ajs28-lgtm/elec327_final_project/docs/final_pcb.webp

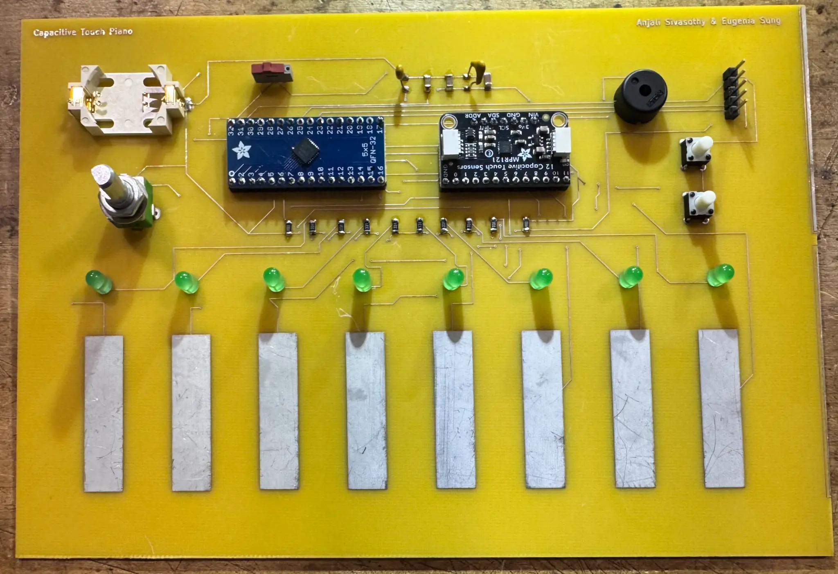
docs/final_pcb.webp
