ajs28-lgtm/elec327_final_project/docs/docs/ELEC327ProjectSlides.pdf

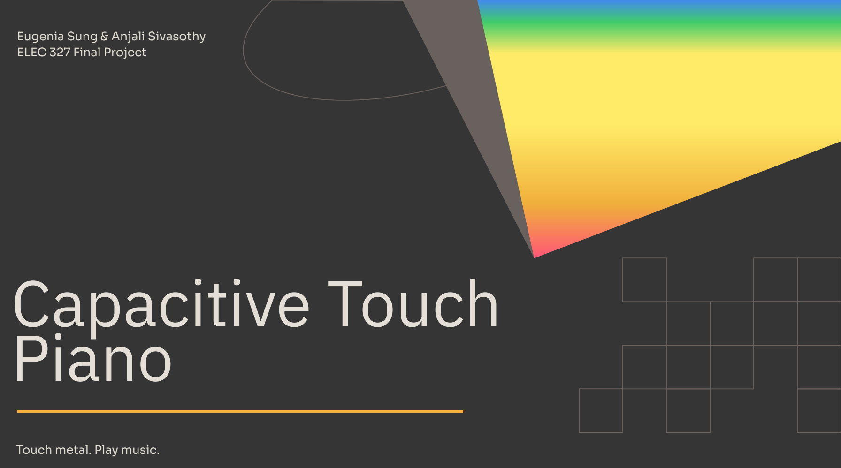
[picture p2: figure]
Eugenia Sung & Anjali Sivasothy ELEC 327 Final Project; Capacitive Touch Piano; Touch metal. Play music.
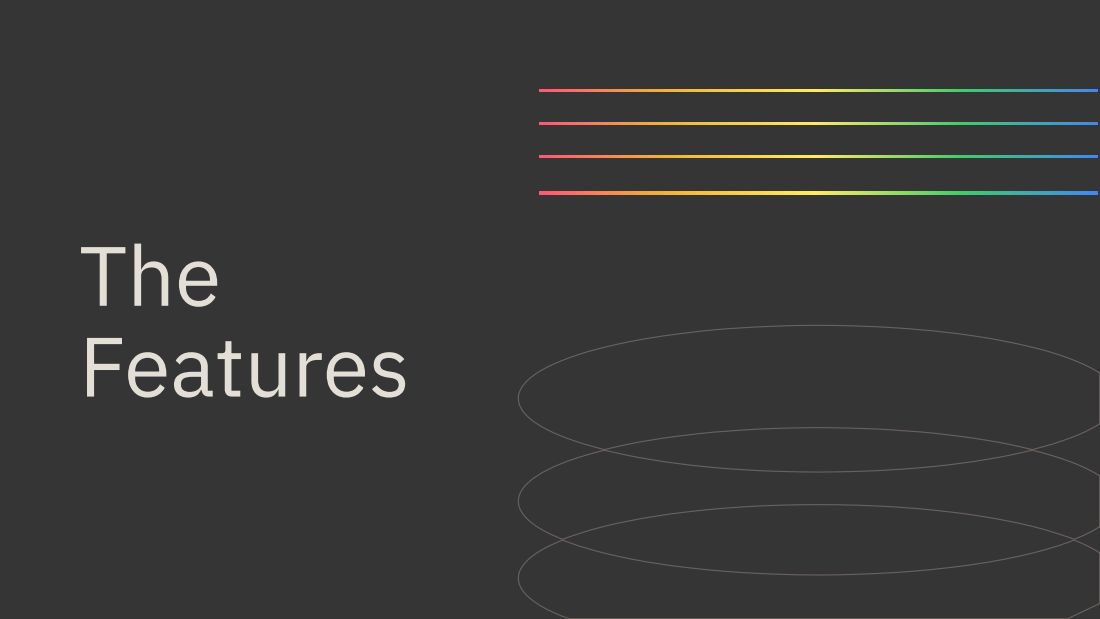
[picture p3: page 2]
The Features

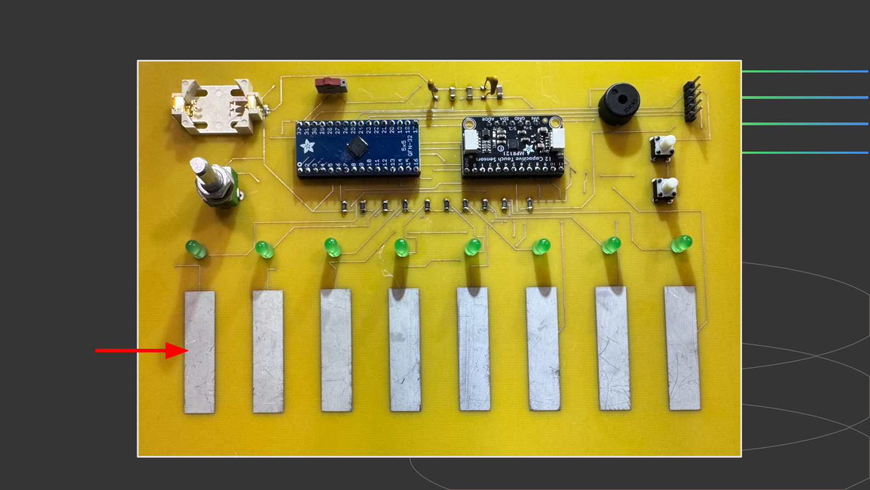
[picture p4: page 3]

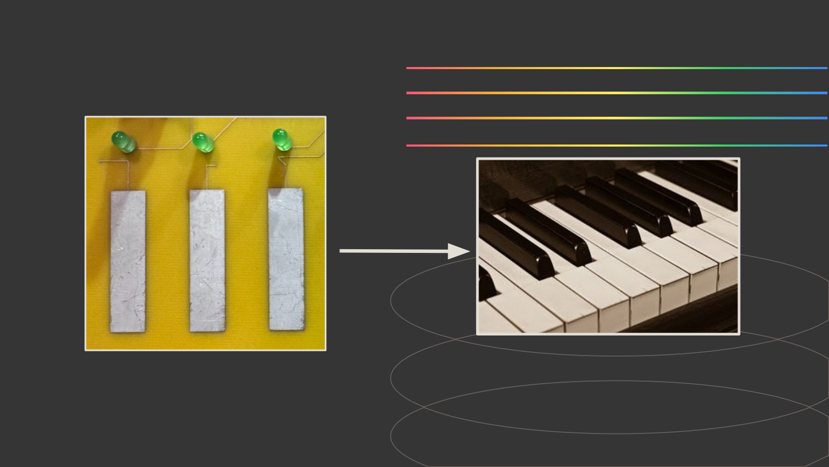
[picture p5: page 4]

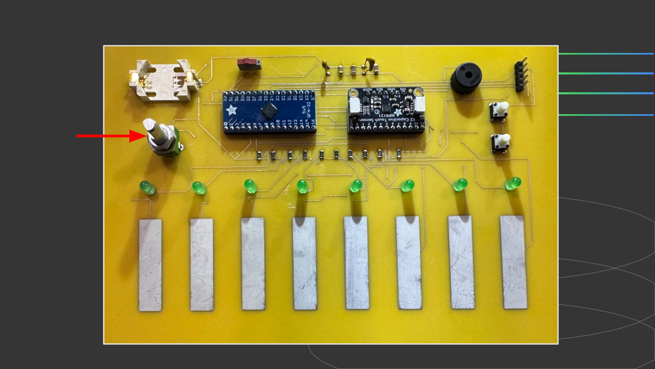
[picture p6: page 5]

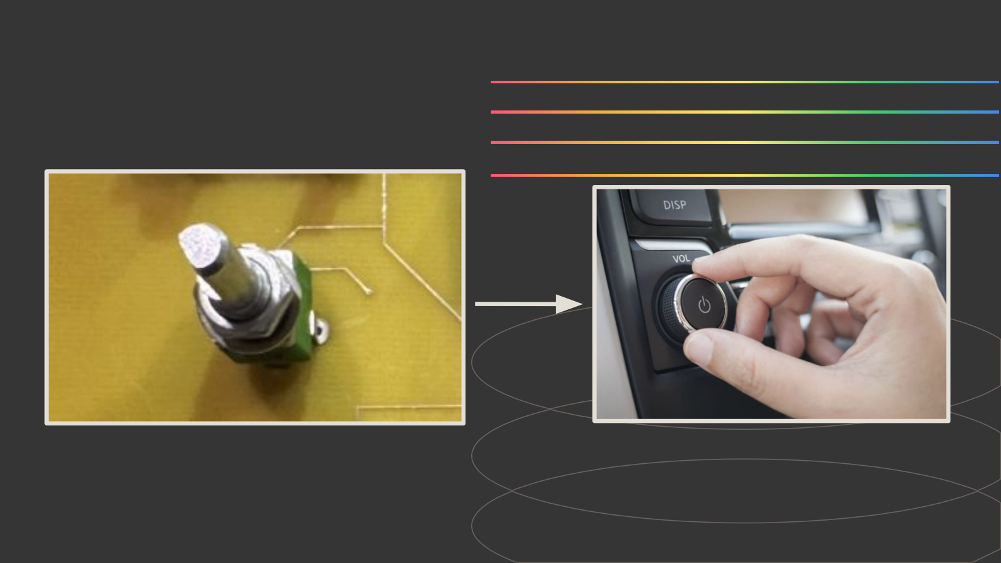
[picture p7: page 6]

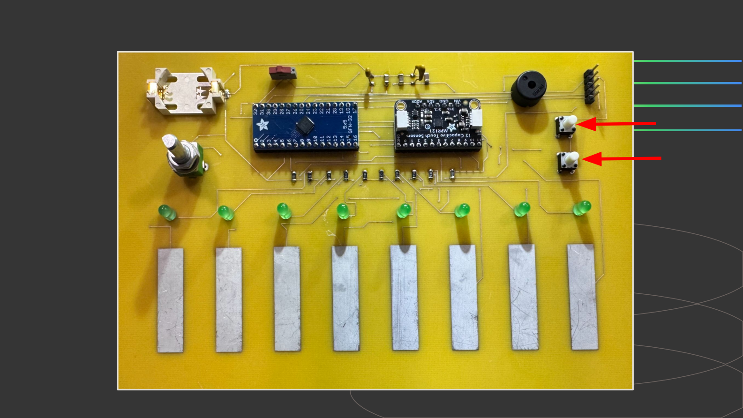
[picture p8: page 7]

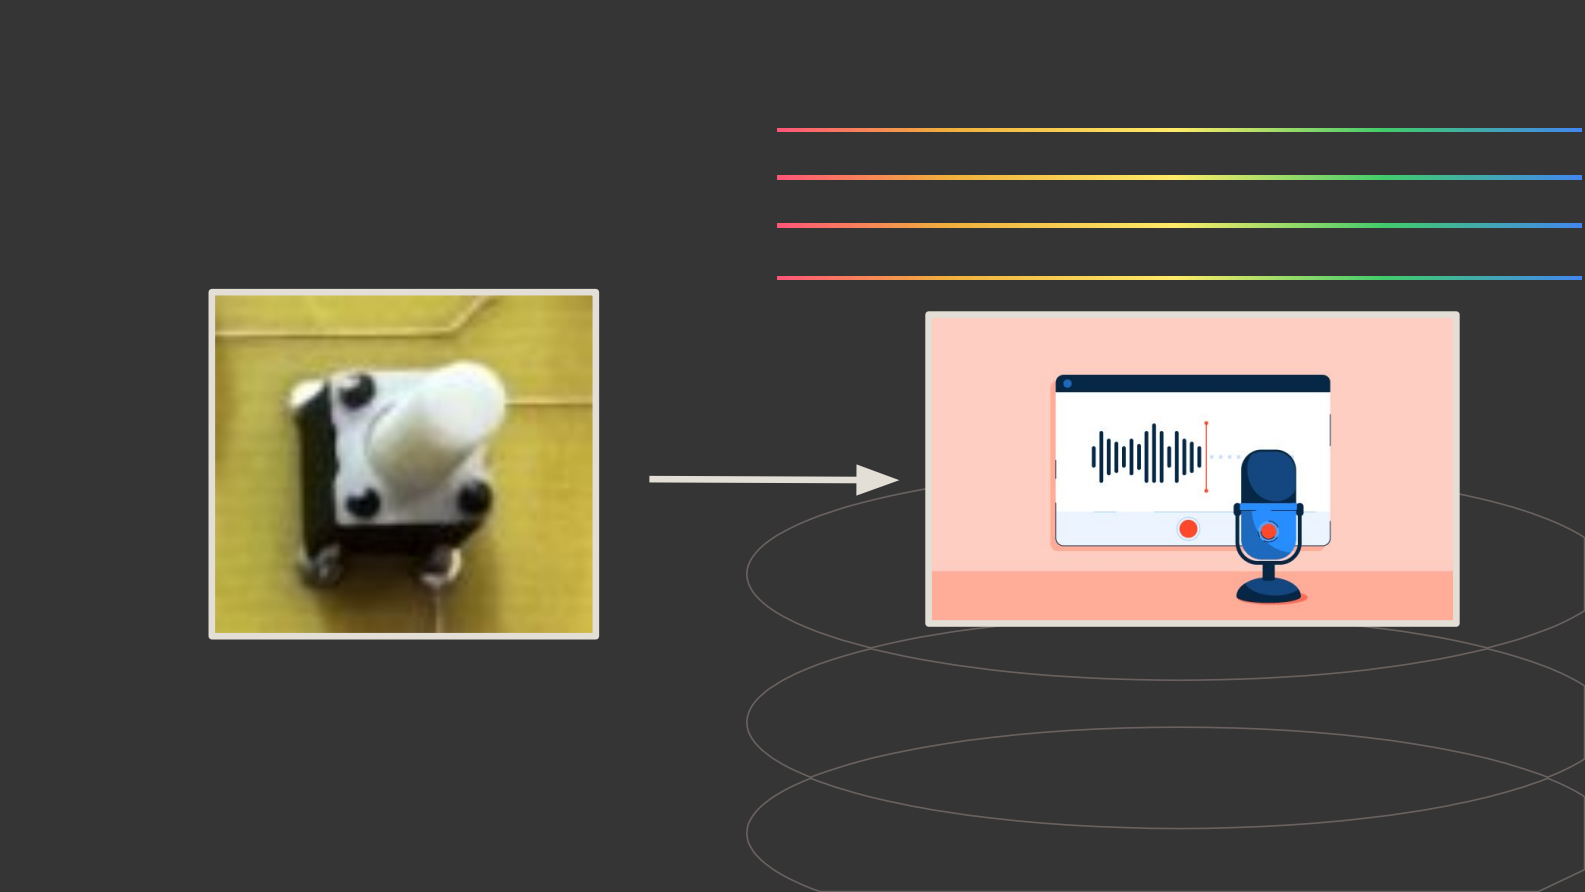
[picture p9: page 8]

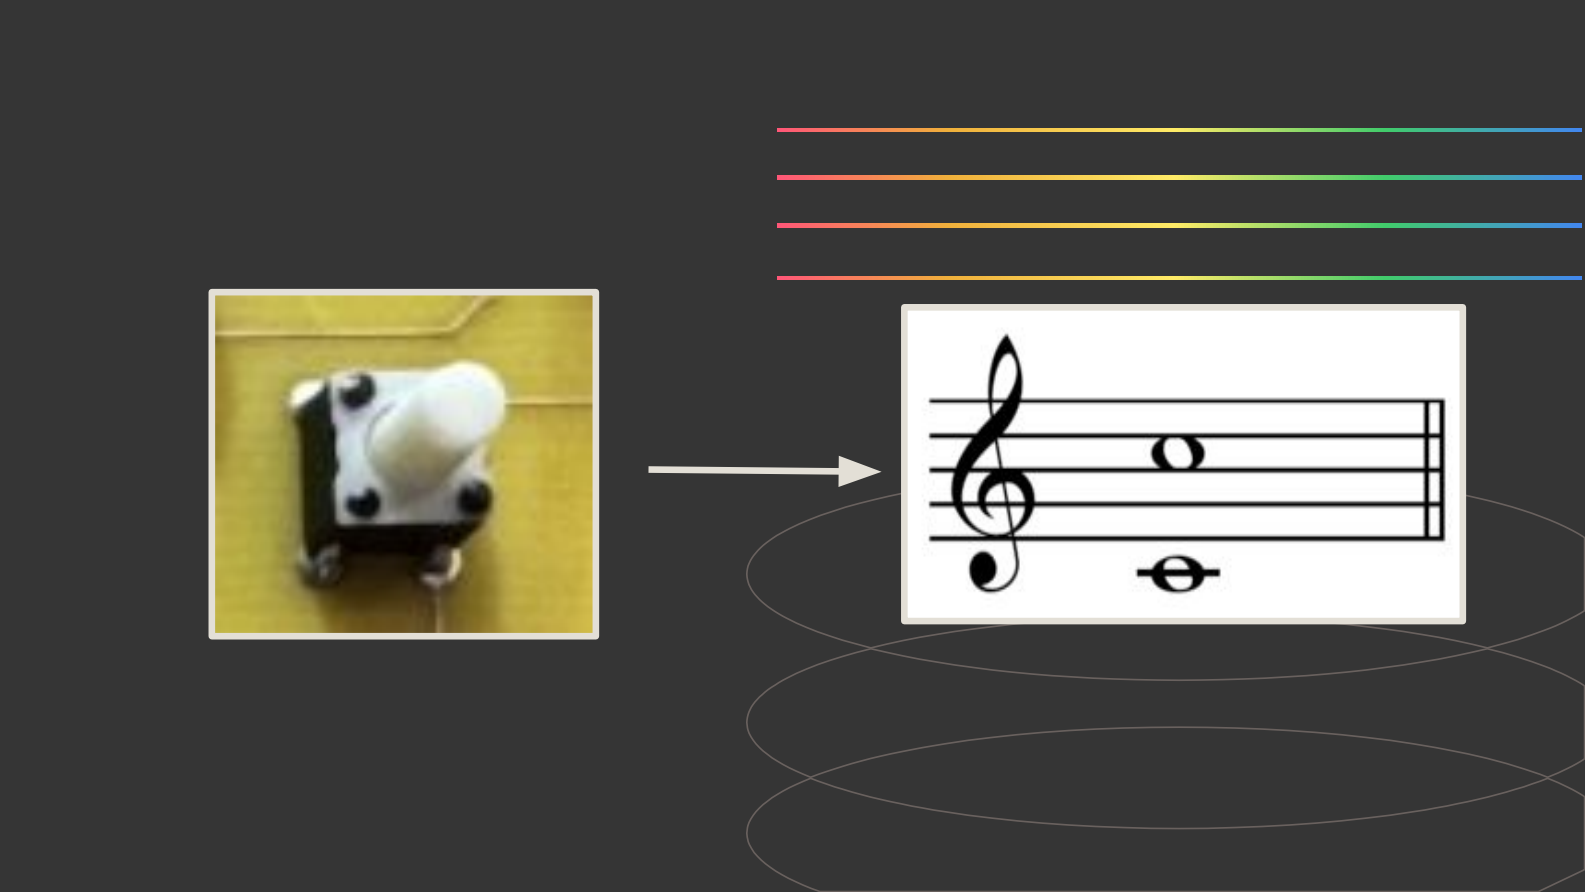
[picture p10: page 9]

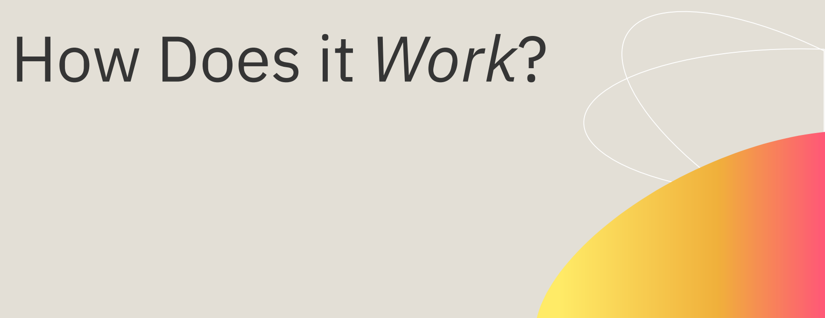
[picture p11: figure]
How Does it Work?

## How Do the Keys Work?

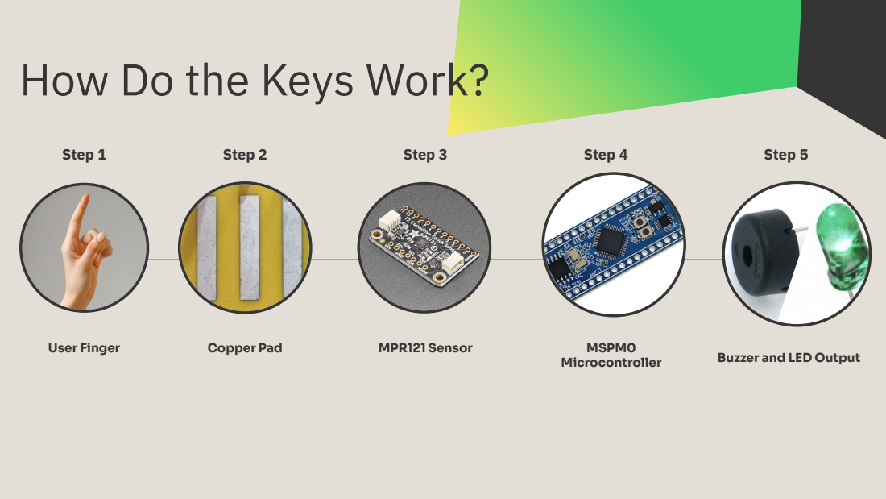
[picture p12: page 11]
Step 1; Step 2; Step 3; Step 4; Step 5; User Finger; MPR121 Sensor; MSPM0; Microcontroller; Copper Pad

Buzzer and LED Output

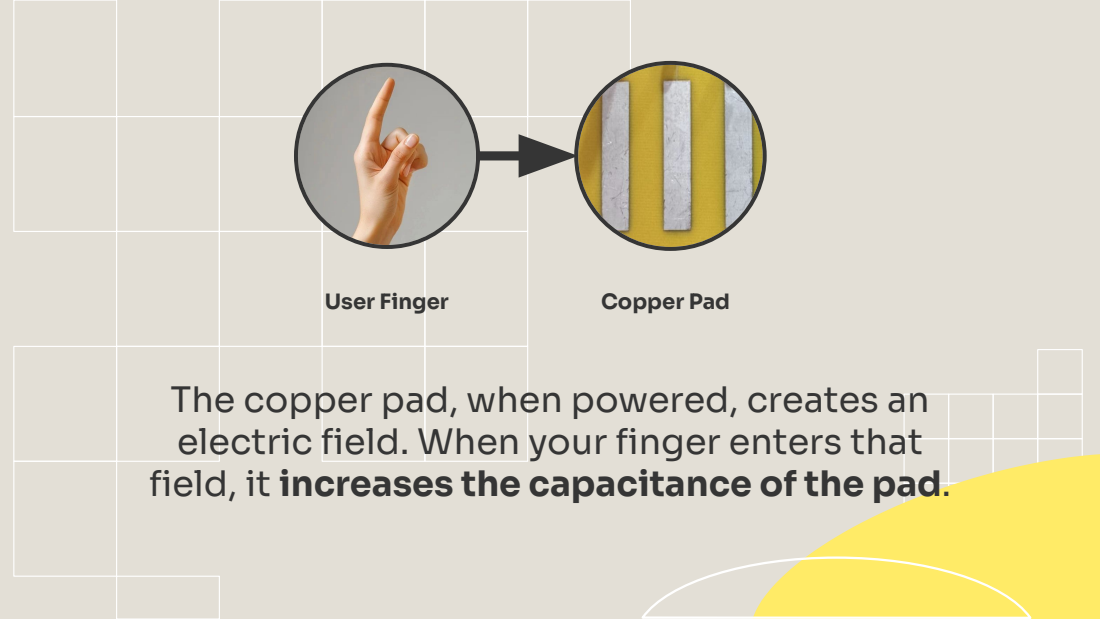
[picture p13: page 12]
User Finger; Copper Pad

The copper pad, when powered, creates an
electric field. When your finger enters that
field, it increases the capacitance of the pad.

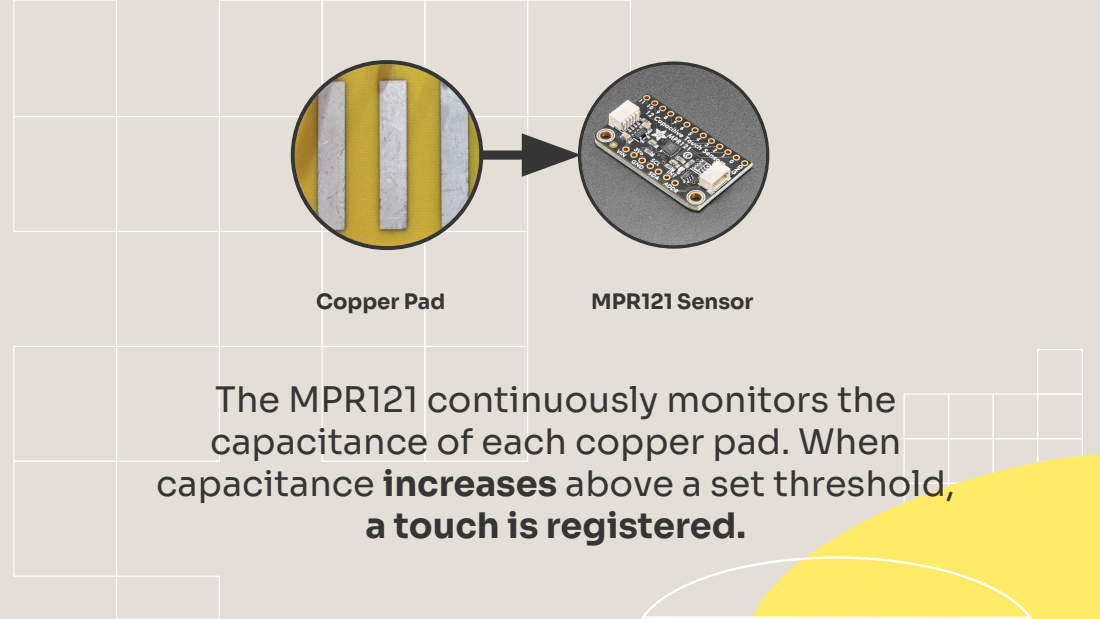
[picture p14: page 13]
Copper Pad; MPR121 Sensor

The MPR121 continuously monitors the
capacitance of each copper pad. When
capacitance increases above a set threshold,

a touch is registered.

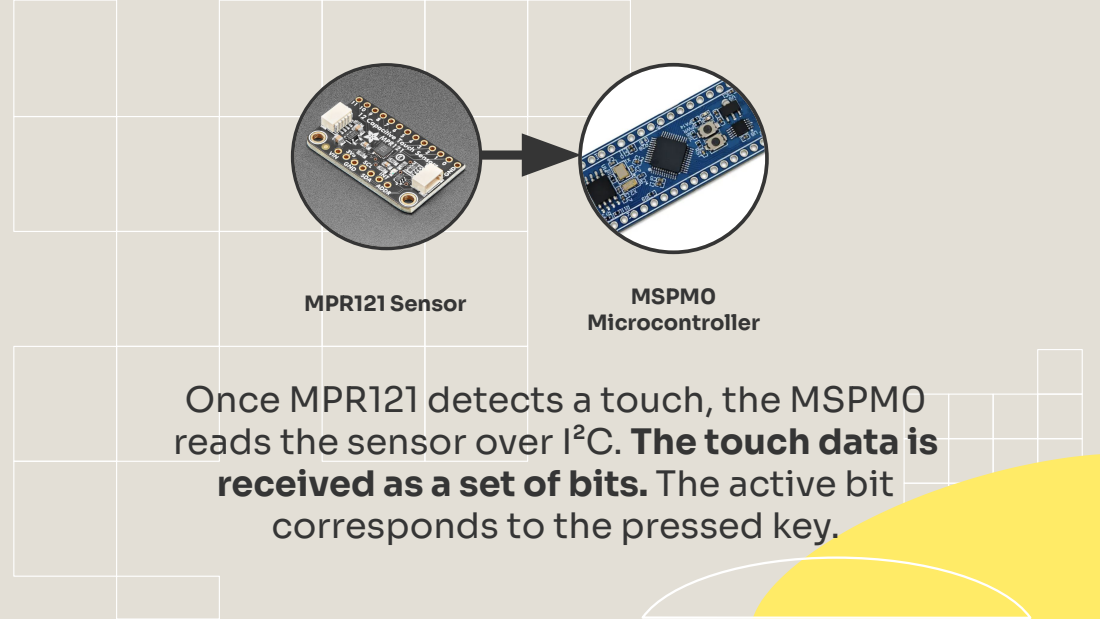
[picture p15: page 14]
MPR121 Sensor; MSPM0 Microcontroller

Once MPR121 detects a touch, the MSPM0
reads the sensor over I²C. The touch data is
received as a set of bits. The active bit
corresponds to the pressed key.

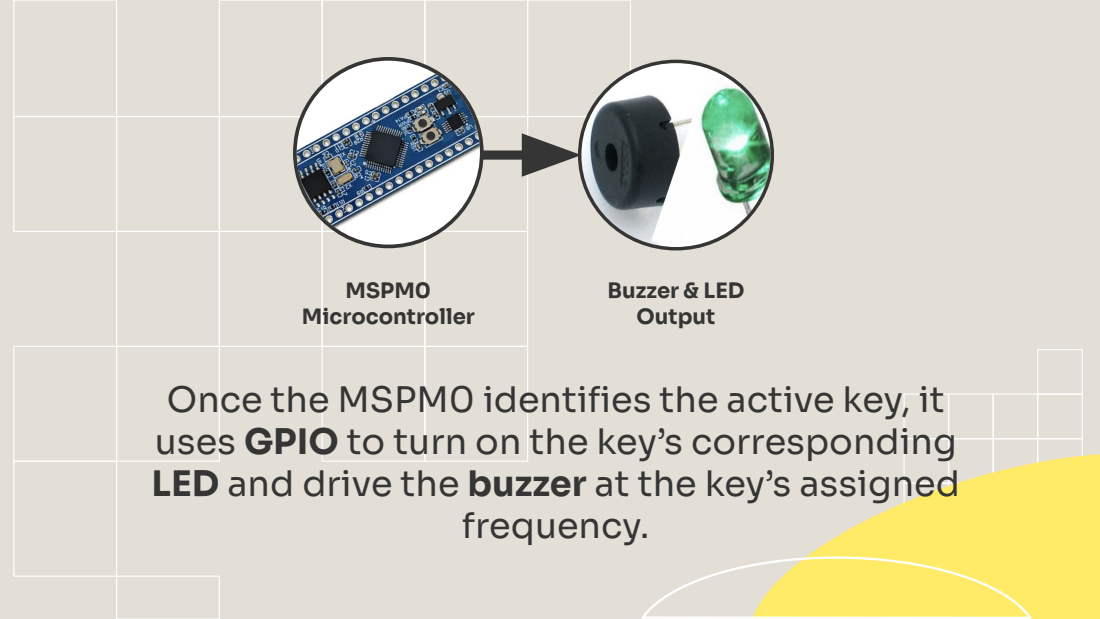
[picture p16: page 15]
frequency.; MSPM0 Microcontroller; Buzzer & LED Output

Once the MSPM0 identifies the active key, it
uses GPIO to turn on the key’s corresponding
LED and drive the buzzer at the key’s assigned

## How Does the Buzzer Make

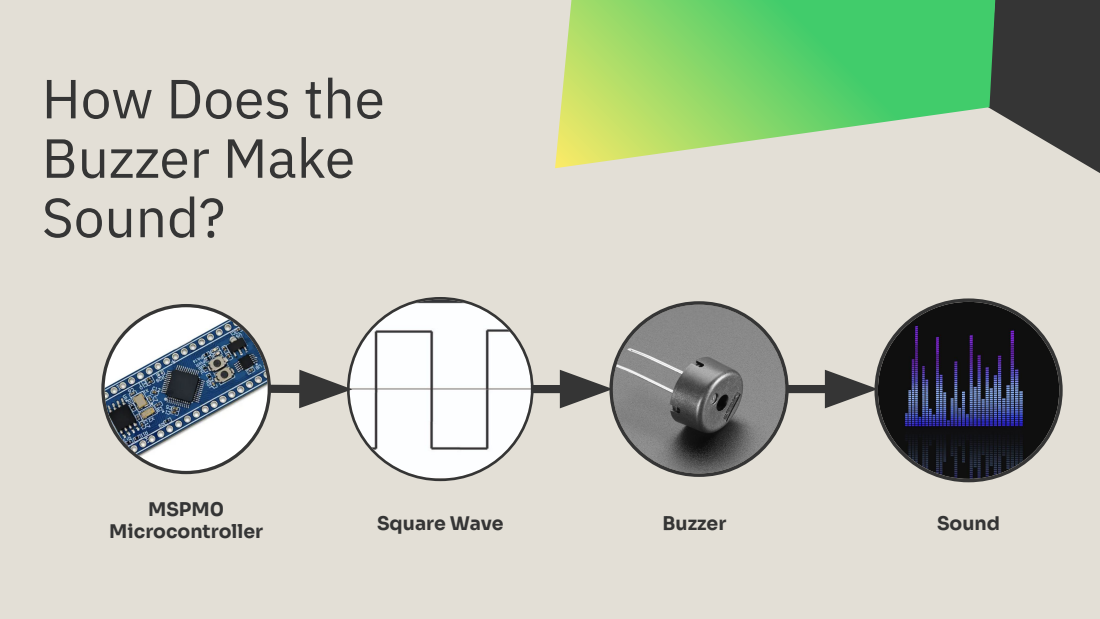
[picture p17: page 16]
Sound?; MSPM0; Microcontroller; Square Wave; Buzzer; Sound

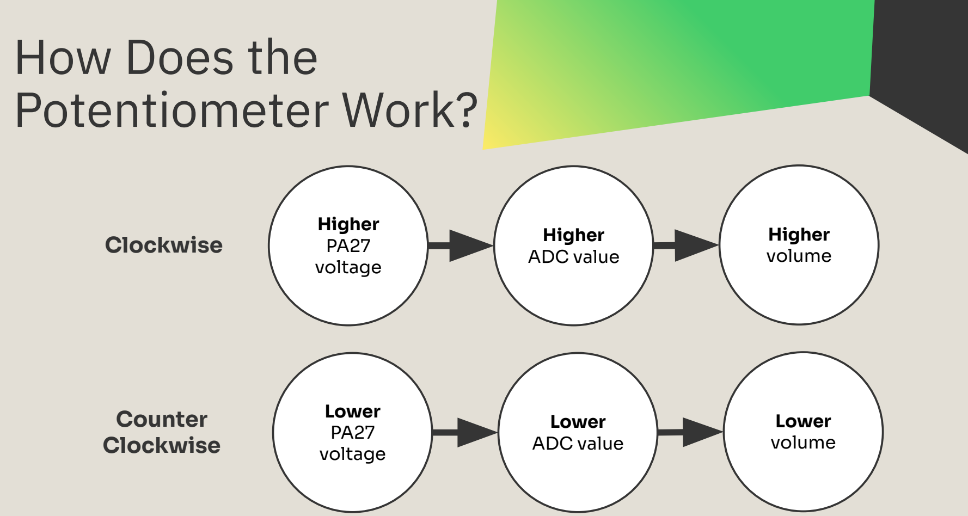
[picture p18: figure]
How Does the Potentiometer Work?; Higher PA27 voltage; Higher ADC value; Higher volume Clockwise; Lower PA27 voltage; Lower ADC value; Lower volume; Counter Clockwise

## How Does the Playback Button Work?

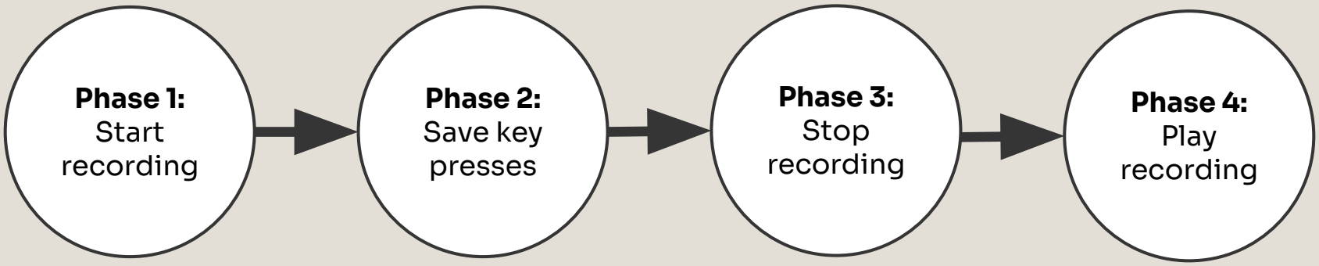
[picture p19: figure]
Phase 1: Start recording; Phase 2: Save key presses; Phase 3: Stop recording; Phase 4: Play recording

## How does Octave Button Work?

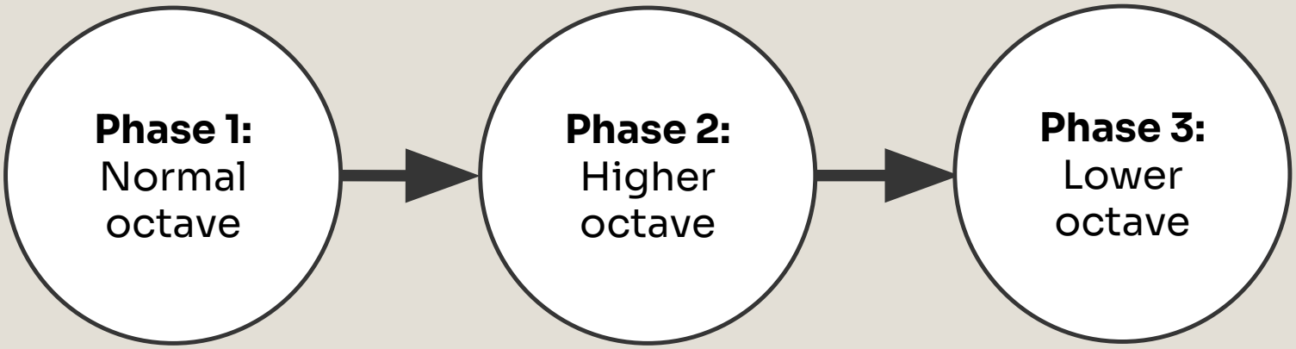
[picture p20: figure]
Phase 1: Normal octave; Phase 2: Higher octave; Phase 3: Lower octave

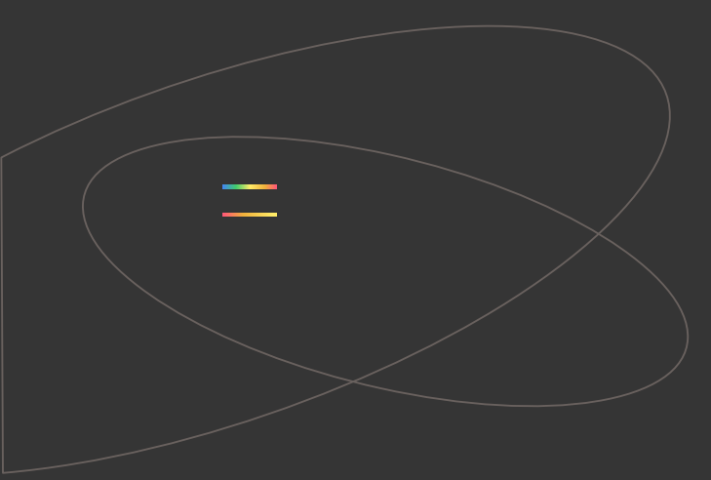
[picture p21: figure]

# Design Decisions

- Optimal electrode geometry?
- Extremely sensitive to noise and layout
- What counts as noise vs a real touch?
- Will this even work after fabrication?

## Custom Capacitive Sensing is Hard

## Using the MPR121

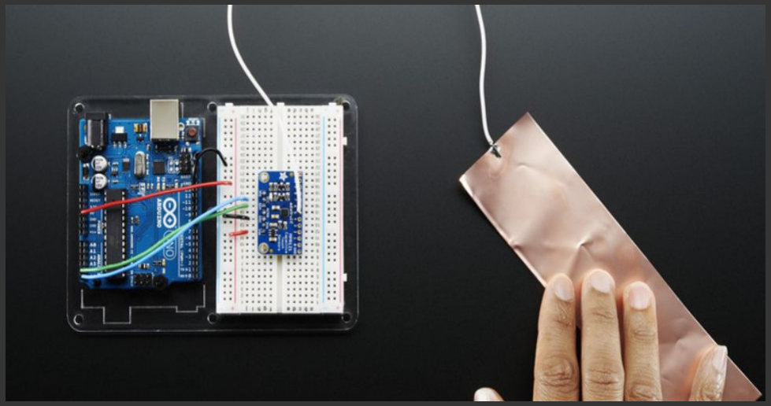
[picture p22: figure]

Reliably offloads capacitive sensing

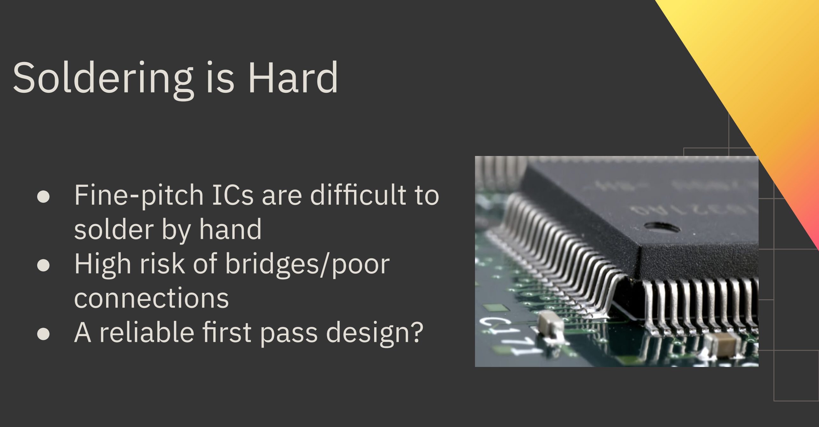
[picture p23: figure]
Soldering is Hard; ● Fine-pitch ICs are difficult to solder by hand ● High risk of bridges/poor connections ● A reliable first pass design?

## Breakout Boards

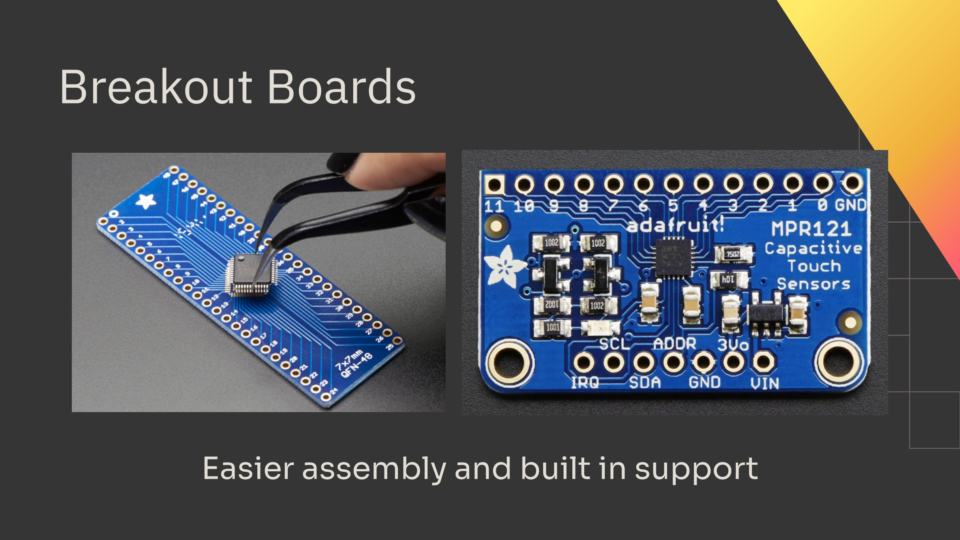
[picture p24: page 24]

Easier assembly and built in support

## Mixed Signal PCB Layout

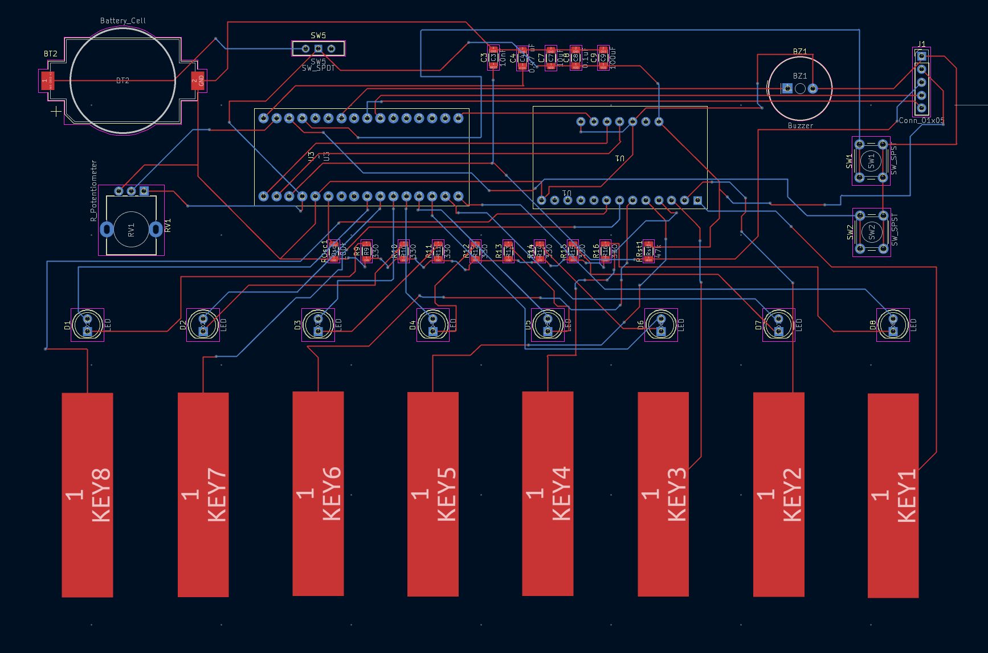
[picture p25: figure]

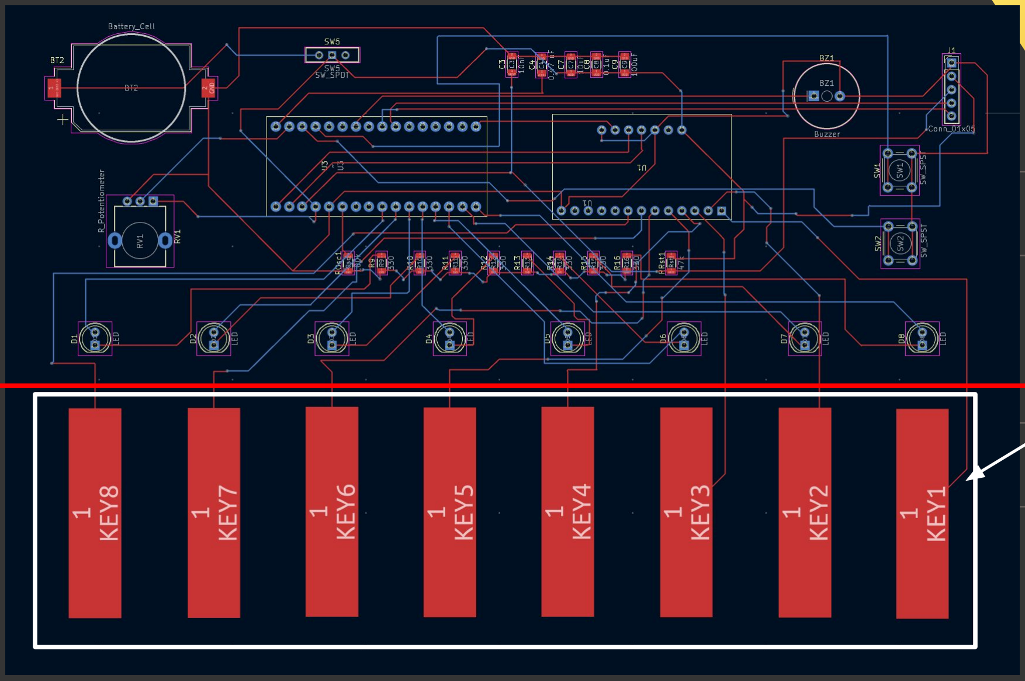
[picture p26: figure]

High
Noise
Region

Low
| Noise Region

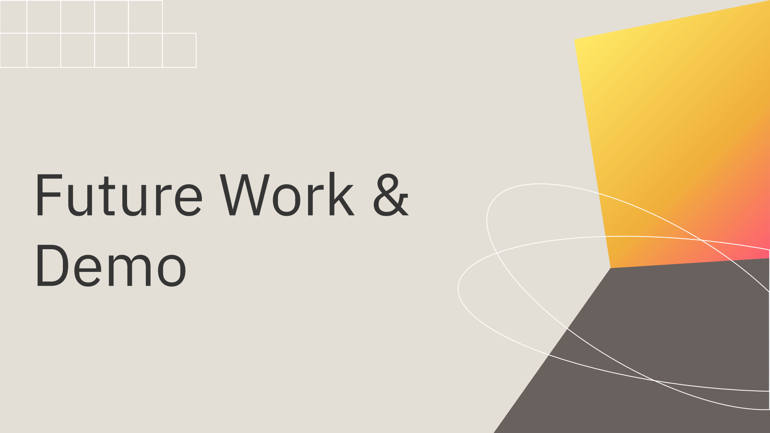
[picture p27: figure]
Future Work & Demo
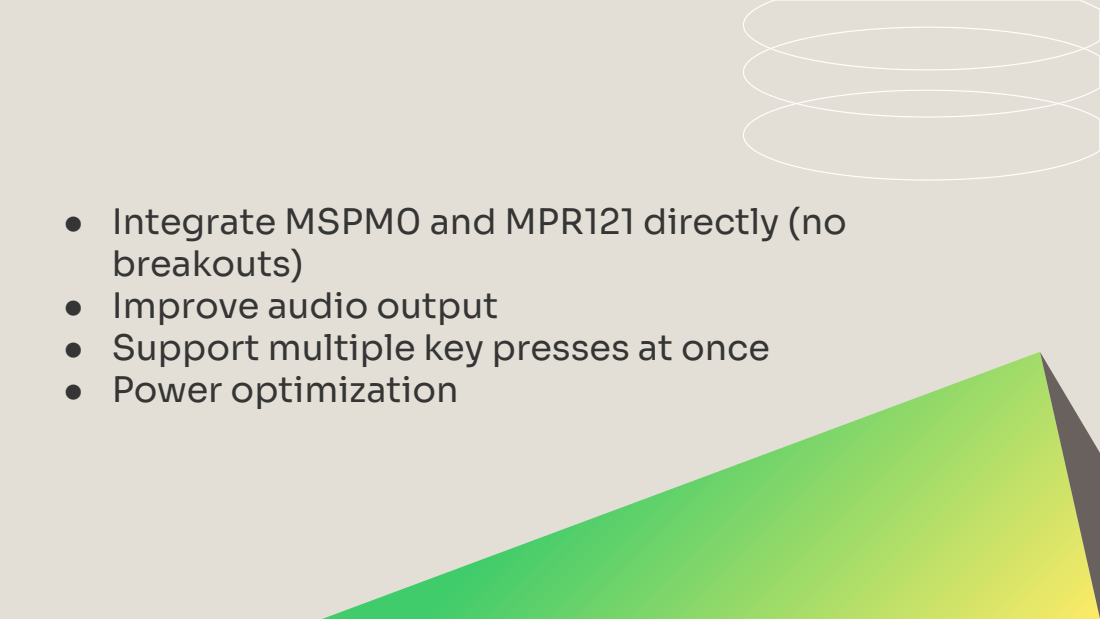
[picture p28: page 28]

● Integrate MSPM0 and MPR121 directly (no
breakouts)
● Improve audio output
● Support multiple key presses at once
● Power optimization
