ajs28-lgtm/elec327_final_project/hardware/kicad/cap_piano_project_327.kicad_pcb

## KiCad design hardware/kicad/cap_piano_project_327.kicad_pcb (2026-05-04)

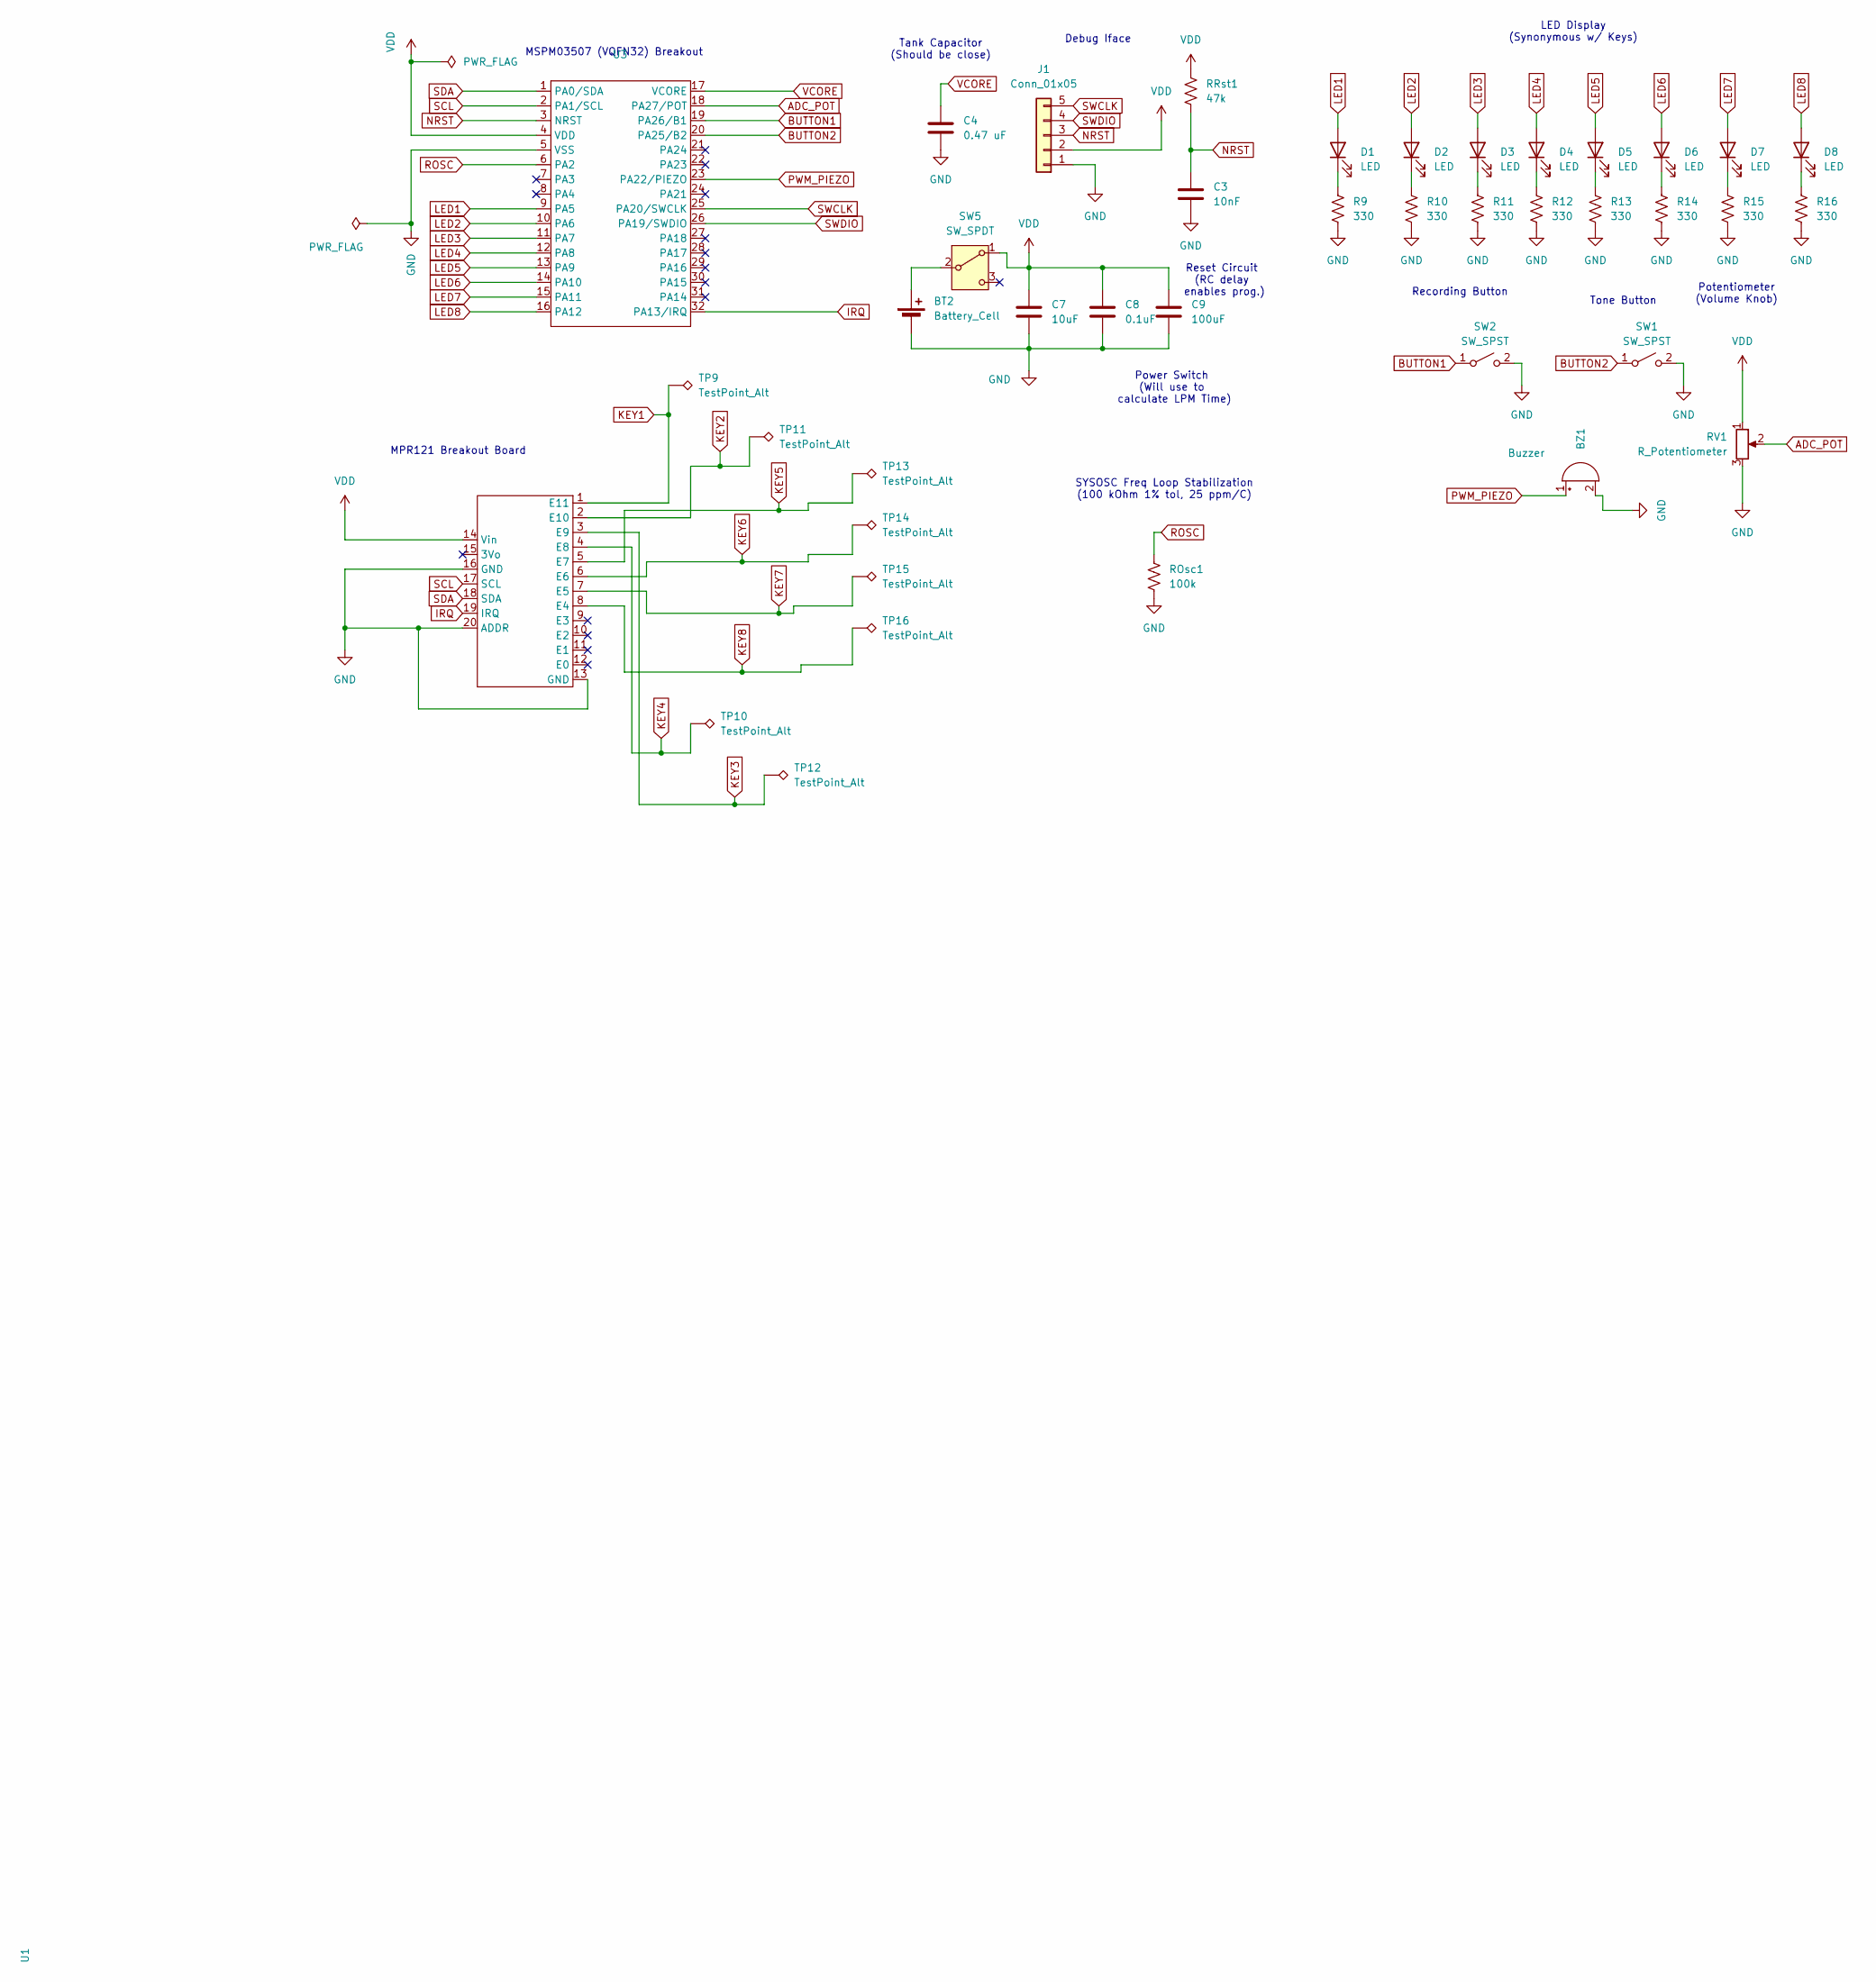
[picture p29: schematic cap_piano_project_327.kicad_sch]

Parts:
BT2: Battery_Cell; BatteryHolder_Keystone_1060_1x2032; MPN C7498148; LCSC Part # C7498148
BZ1: Buzzer; Buzzer_TDK_PS1240P02BT_D12.2mm_H6.5mm
C3: 10nF; C_1206_3216Metric_Pad1.33x1.80mm_HandSolder
C4: 0.47 uF; C_1206_3216Metric_Pad1.33x1.80mm_HandSolder
C7: 10uF; C_1206_3216Metric_Pad1.33x1.80mm_HandSolder; LCSC Part # C19702
C8: 0.1uF; C_1206_3216Metric_Pad1.33x1.80mm_HandSolder; LCSC Part # C1591
C9: 100uF; C_1206_3216Metric_Pad1.33x1.80mm_HandSolder; LCSC Part # C15008
D1, D2, D3, D4, D5, D6, D7, D8: LED; LED_D5.0mm
J1: Conn_01x05; PinHeader_1x05_P2.54mm_Vertical; MPN C492413
R9, R10, R11, R12, R13, R14, R15, R16: 330; R_1206_3216Metric
ROsc1: 100k; R_1206_3216Metric
RRst1: 47k; R_1206_3216Metric
RV1: R_Potentiometer; Potentiometer_Alpha_RD901F-40-00D_Single_Vertical
SW1, SW2: SW_SPST; SW_PUSH_6mm_H5mm
SW5: SW_SPDT; SW_Slide-03_Wuerth-WS-SLTV_10x2.5x6.4_P2.54mm; MPN C20611678; LCSC Part # C20611678
TP9, TP10, TP11, TP12, TP13, TP14, TP15, TP16: TestPoint_Alt; TestPoint_Pad_4.0x4.0mm
U1: Adafruit_MPR121_1982_Socket
U3: SMT Breakout PCB - 32-QFN

Connections:
ADC_POT: RV1.2, U3.18 (PA27/POT)
BUTTON1: SW2.1 (A), U3.19 (PA26/B1)
BUTTON2: SW1.1 (A), U3.20 (PA25/B2)
GND: BT2.2 (-), BZ1.2 (-), C3.2, C4.2, C7.2, C8.2, C9.2, J1.1, R9.1, R10.1, R11.1, R12.1, R13.1, R14.1, R15.1, R16.1, ROsc1.1, RV1.3, SW1.2 (B), SW2.2 (B), U1.13 (GND), U1.16 (GND), U1.20 (ADDR), U3.5 (VSS)
IRQ: U1.19 (IRQ), U3.32 (PA13/IRQ)
KEY1: TP9.1, U1.1 (E11)
KEY2: TP11.1, U1.2 (E10)
KEY3: TP12.1, U1.3 (E9)
KEY4: TP10.1, U1.4 (E8)
KEY5: TP13.1, U1.5 (E7)
KEY6: TP14.1, U1.6 (E6)
KEY7: TP15.1, U1.7 (E5)
KEY8: TP16.1, U1.8 (E4)
LED1: D1.2 (A), U3.9 (PA5)
LED2: D2.2 (A), U3.10 (PA6)
LED3: D3.2 (A), U3.11 (PA7)
LED4: D4.2 (A), U3.12 (PA8)
LED5: D5.2 (A), U3.13 (PA9)
LED6: D6.2 (A), U3.14 (PA10)
LED7: D7.2 (A), U3.15 (PA11)
LED8: D8.2 (A), U3.16 (PA12)
NRST: C3.1, J1.3, RRst1.1, U3.3 (NRST)
unnamed: BT2.1 (+), SW5.2 (B)
unnamed: D1.1 (K), R9.2
unnamed: D2.1 (K), R10.2
unnamed: D3.1 (K), R11.2
unnamed: D4.1 (K), R12.2
unnamed: D5.1 (K), R13.2
unnamed: D6.1 (K), R14.2
unnamed: D7.1 (K), R15.2
unnamed: D8.1 (K), R16.2
PWM_PIEZO: BZ1.1 (+), U3.23 (PA22/PIEZO)
ROSC: ROsc1.2, U3.6 (PA2)
SCL: U1.17 (SCL), U3.2 (PA1/SCL)
SDA: U1.18 (SDA), U3.1 (PA0/SDA)
SWCLK: J1.5, U3.25 (PA20/SWCLK)
SWDIO: J1.4, U3.26 (PA19/SWDIO)
VCORE: C4.1, U3.17 (VCORE)
VDD: C7.1, C8.1, C9.1, J1.2, RRst1.2, RV1.1, SW5.1 (A), U1.14 (Vin), U3.4 (VDD)

Notes on the sheet:
Power Switch (Will use to calculate LPM Time)
Recording Button
LED Display (Synonymous w/ Keys)
SYSOSC Freq Loop Stabilization (100 kOhm 1% tol, 25 ppm/C)
MSPM03507 (VQFN32) Breakout
Tank Capacitor (Should be close)
Potentiometer (Volume Knob)
Tone Button
Debug Iface
MPR121 Breakout Board
Reset Circuit (RC delay enables prog.)

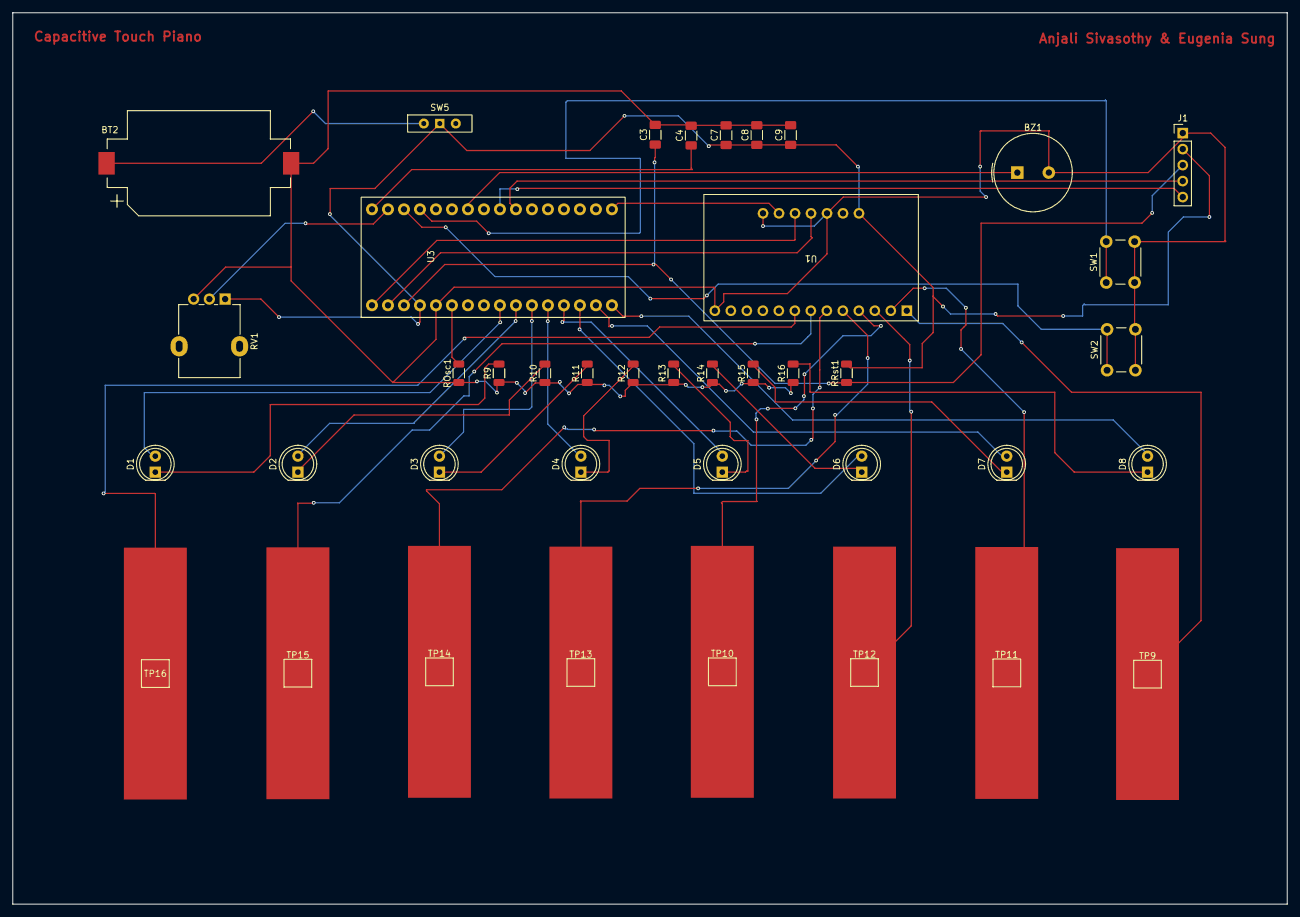
[picture p30: board cap_piano_project_327.kicad_pcb from above]

Board: 2 copper layers, 202.4 x 141.5 mm, 40 parts (0 on the bottom side), 39 nets.
