ajs28-lgtm/elec327_final_project/(commit log)

2026-05-04 Initial KiCad project
    [cap_piano_project_327.kicad_pcb, cap_piano_project_327.kicad_sch]
2026-05-04 Organize firmware and KiCad files
    [cap_piano_project_327.kicad_pcb, cap_piano_project_327.kicad_sch]
2026-05-04 Added comments to I2C
2026-05-05 Update main.c
    Added comments to buttons and pot
